LTG2012/super-dial-motor-knob-screen/superdial使用说明书.pdf

默认 HID

设置界面

亮度：范围 1-100，转动到低时有电机软限位
息屏时间：不操作时屏幕熄灭；可选 30 秒、1 分钟、3 分钟、5 分钟、10 分钟、15 分钟、 从不息屏
关机时间：不操作自动关机时间；可选 1 分钟、3 分钟、5 分钟、10 分钟、15 分钟、30 分 钟、从不息屏
屏幕方向:屏幕显示方向；四个方向可调，每个方向间隔 90 度
Wifi：
STA 联网模式；长按联网后会访问对应的 wifi 热点，成功时会显示 IP 地址。在同一 wifi 热点内，打开浏览器访问 IP 地址会有设置网页
AP 热点模式；第一次使用需要进入到 AP 热点模式进行配网，wifi 名称“Superdial-xxxxxx”， 后六位是设备唯一 ID，在验证码获取时候需要填入后六位设备唯一 ID；验证码获取可以参 考项目 readme 里面说明，项目说明：https://gitee.com/coll45/super-dial-motor-knobscreen。选中对应 (https://gitee.com/coll45/super-dial-motor-knob-screen) wifi 名称，填入密码和验证码 默认首页：开机启动后默认打开的页面；可选首页，默认 HID，自定义 HID
