LTG2012/super-dial-motor-knob-screen/image/wifi_pwd.png

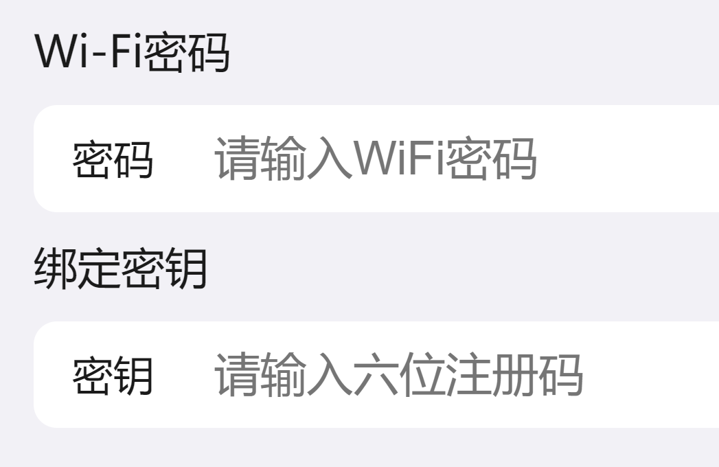
image/wifi_pwd.png
