LTG2012/super-dial-motor-knob-screen/image/wifi_ssid.png

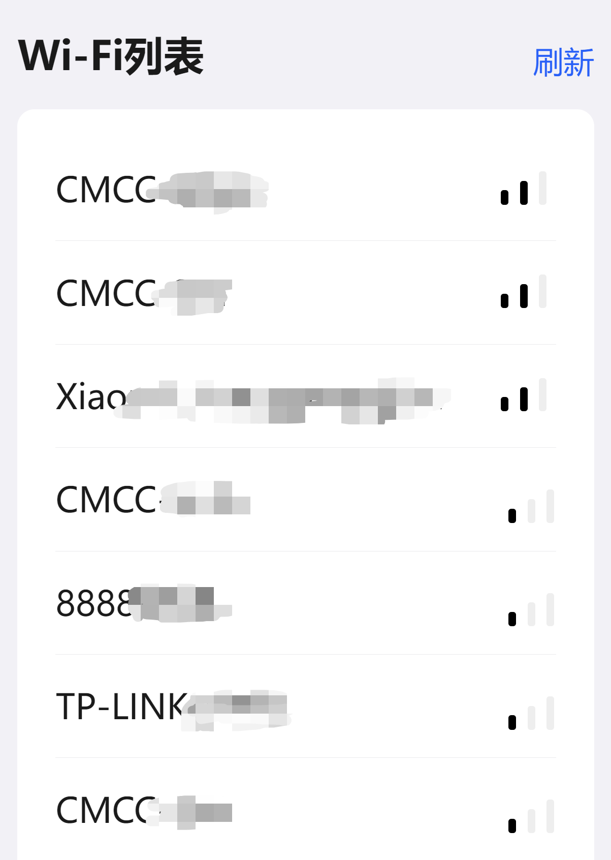
image/wifi_ssid.png
