LTG2012/super-dial-motor-knob-screen/image/首页2.png

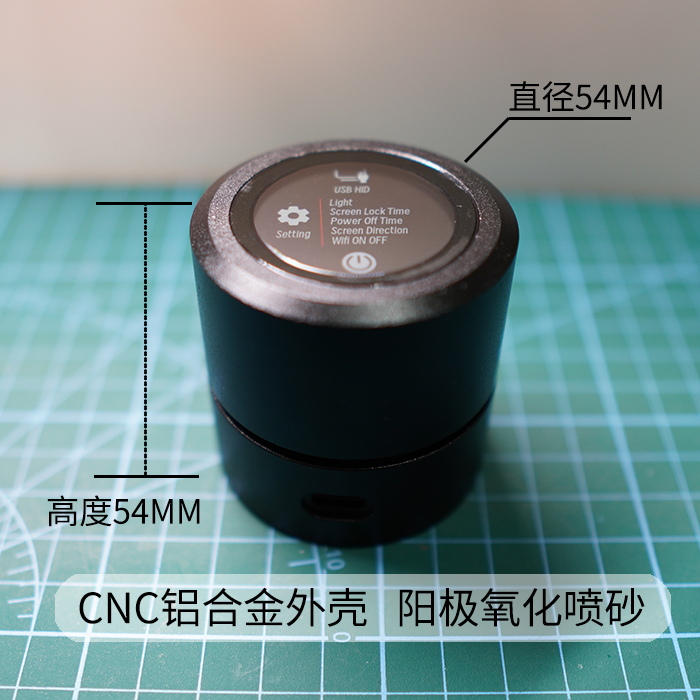
image/首页2.png
