LTG2012/super-dial-motor-knob-screen/3205B电机SuperDial_Bom.xlsx

Sheet: 打印或CNC
SuperDial电机旋钮屏V2物料清单（打印件）
除旋钮外，均不需要添加支撑
旋钮同时支持CNC加工和3D打印
详见stl文件和step文件

Sheet: 其他辅料
SuperDial电机旋钮屏V2物料清单（其他辅料） |  |  |  | 链接
序号 | 数量 | 名称 | 备注
1 | 1 | 直径40mm厚度1mm玻璃 | 屏幕保护 | https://item.taobao.com/item.htm?abbucket=20&id=553695645065&ns=1&skuId=3728391490097
2 | 4 | M2*3杯头内六角螺丝 | 固定转子套 | https://detail.tmall.com/item.htm?id=43519715236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
3 | 3 | M2*5螺丝 | 固定主控和底座 | 可在上面链接配齐
4 | 1 | M2.5*5螺丝 | 辅助铜柱焊接 | 螺丝数量为用到的数量，实际上做一套旋钮只需要每个规格螺丝拍一件商品就行
5 | 6 | M2*12内六角半牙螺丝 | 穿过驱动板固定到电机/穿过主控板固定到适配器 | https://detail.tmall.com/item.htm?_u=p1sddf3sf272&id=687938827035&skuId=5075553231849
6 | 4 | M2*6.6MM飞控避震柱 | 套在半牙M2*12螺丝外 | https://item.taobao.com/item.htm?_u=p1sddf3s656f&id=648151872187&skuId=4864013272254
7 | 1 | M2.5*25六角铜柱双通 | 过屏幕线，得用（佰瑞特紧固件企业店）的铜柱 | https://item.taobao.com/item.htm?_u=p1sddf3s5d27&id=20345879255&skuId=5173597151816
8 | 1 | 502胶水 | 固定屏幕玻璃到打印件上
9 | 1 | 间距0.8mm 8P 32AWG单头线 | 屏幕线，长度20cm | https://item.taobao.com/item.htm?_u=p1sddf3sefb6&id=582653807364&skuId=4510259621478
10 | 1 | 间距0.8mm 8P 32AWG双头同向线 | 连接驱动和主控，越短越好（可定制） | 上面链接8p双头同向10cm长度的也可以用，就是要稍微理一下线
11 | 1 | 3205电机B款 无限位 | 在45菌店铺买无限位款可以备注（旋钮）会送对应适配器 | https://item.taobao.com/item.htm?id=734772197083&skuId=5254200511031
12 | 1 | 2P杜邦线适量长度 | 连接主控和驱动，导线自己裁剪合适长度
13 | 1 | 602535锂电池 600mAh | 可小不可大；不带插头、xh2.54和ph2.0均可（线长50mm） | https://item.taobao.com/item.htm?_u=p1sddf3s11e1&id=619805501404&skuId=4627654124871
14 | 1 | 0.15mm双面胶适量 | 固定屏幕，旋钮套和外壳固定
15 | 1 | FPC软天线IPEX 1代 | A款FPC 5DB 37*10mm 线总长6cm IPEX 1代 | https://item.taobao.com/item.htm?_u=p1sddf3s7e17&id=586127342811&skuId=4017577965337
16 | 1 | 直径54mm左右防滑硅胶垫 | 贴在底座底面（定制） | 不影响功能，可不买
17 | 1 | 1.28寸TFT液晶显示屏GC9A01驱动 | 标准焊接款（不带触摸） | https://item.taobao.com/item.htm?_u=q1sddf3sfeb4&id=674420369037&skuId=5027778451275
18 | 1 | ESP32S3-N16R8 | 立创原理图上用的是N8是错的，需要买N16R8 | https://item.taobao.com/item.htm?abbucket=16&id=676604026231&ns=1&skuId=5035236575059
