LTG2012/super-dial-motor-knob-screen/idf_code/components/espressif__esp_lvgl_port/docs/frame_buffer_settings.png

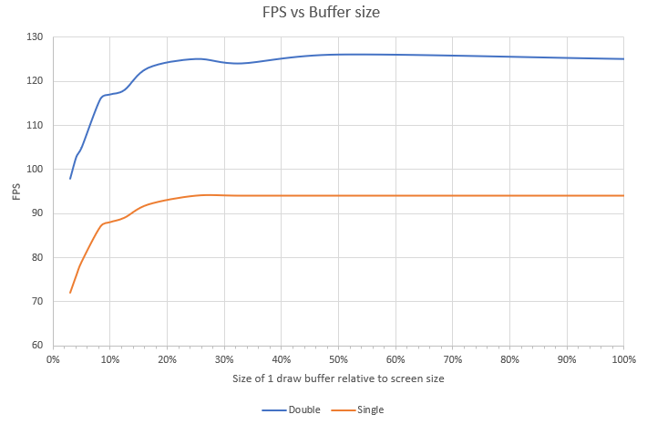
idf_code/components/espressif__esp_lvgl_port/docs/frame_buffer_settings.png
