LTG2012/super-dial-motor-knob-screen/3D打印和CNC模型-by虫二/3205b适配器.STEP

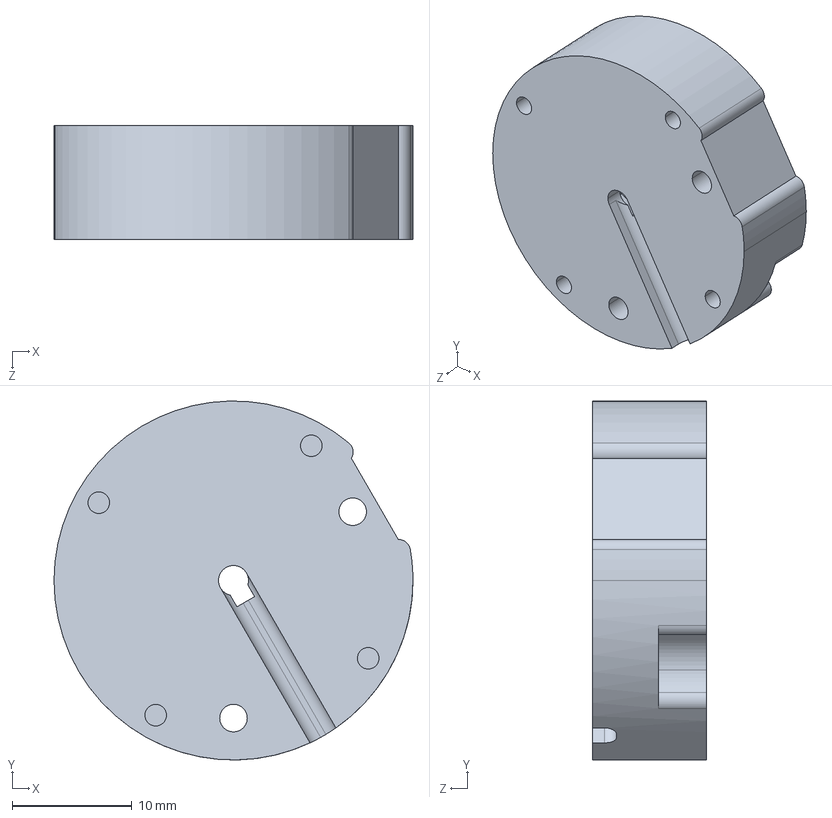
[picture p43: CAD file, 2024-04-28]
3D打印和CNC模型-by虫二/3205b适配器.STEP
30.0 x 30.0 x 9.50 mm
