LTG2012/super-dial-motor-knob-screen/3D打印和CNC模型-by虫二/旋钮上盖.STEP

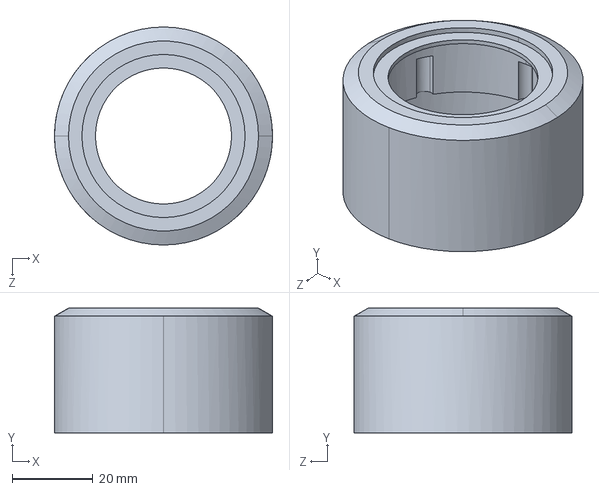
[picture p44: CAD file, 2024-01-25]
3D打印和CNC模型-by虫二/旋钮上盖.STEP
54.0 x 30.9 x 54.0 mm
