LTG2012/super-dial-motor-knob-screen/3D打印和CNC模型-by虫二/3205b电机转子套.STEP

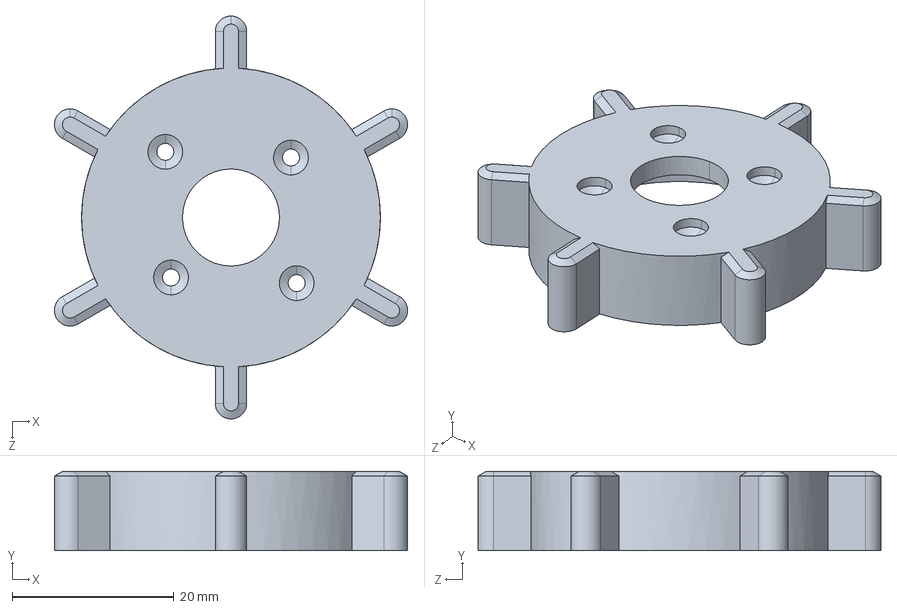
[picture p45: CAD file, 2024-01-25]
3D打印和CNC模型-by虫二/3205b电机转子套.STEP
43.7 x 9.80 x 49.9 mm
