LTG2012/super-dial-motor-knob-screen/3D打印和CNC模型-by虫二/旋钮底座.STEP

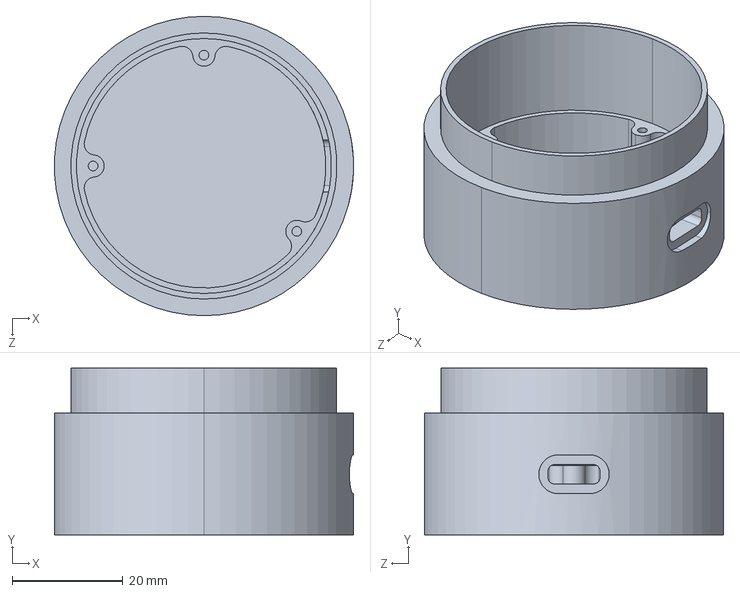
[picture p46: CAD file, 2024-01-25]
3D打印和CNC模型-by虫二/旋钮底座.STEP
53.9 x 30.1 x 54.0 mm
