LTG2012/super-dial-motor-knob-screen/3D打印和CNC模型-by虫二/旧版本3205A电机结构模型_仅供参考/01.旋钮.STL

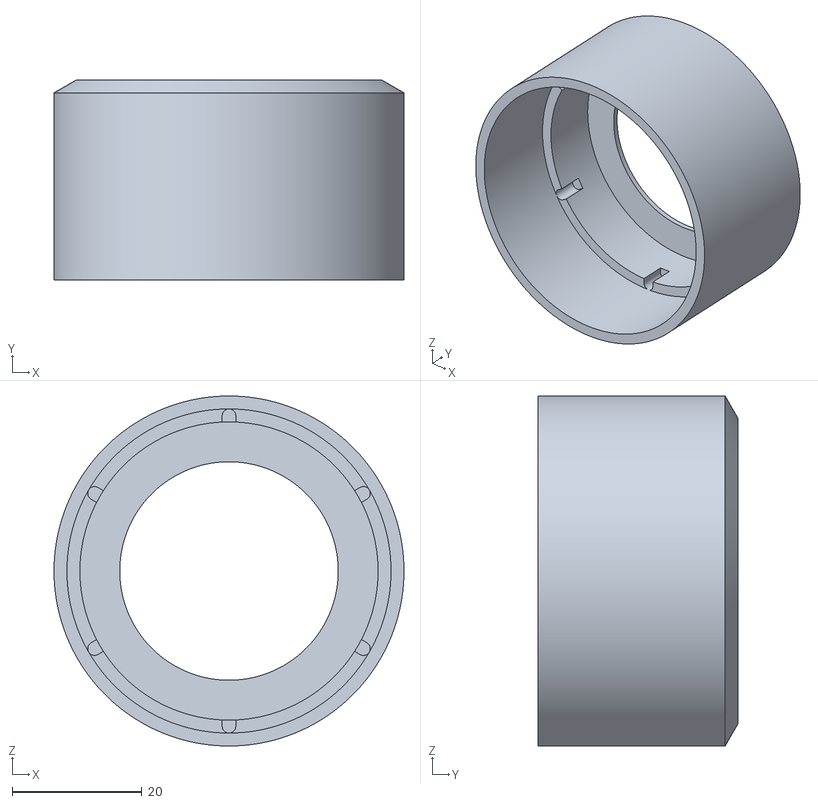
[picture p47: CAD file, 2024-01-25, an earlier design]
3D打印和CNC模型-by虫二/旧版本3205A电机结构模型_仅供参考/01.旋钮.STL
54.0 x 30.9 x 54.0
