LTG2012/super-dial-motor-knob-screen/3D打印和CNC模型-by虫二/旧版本3205A电机结构模型_仅供参考/04.转子套.STL

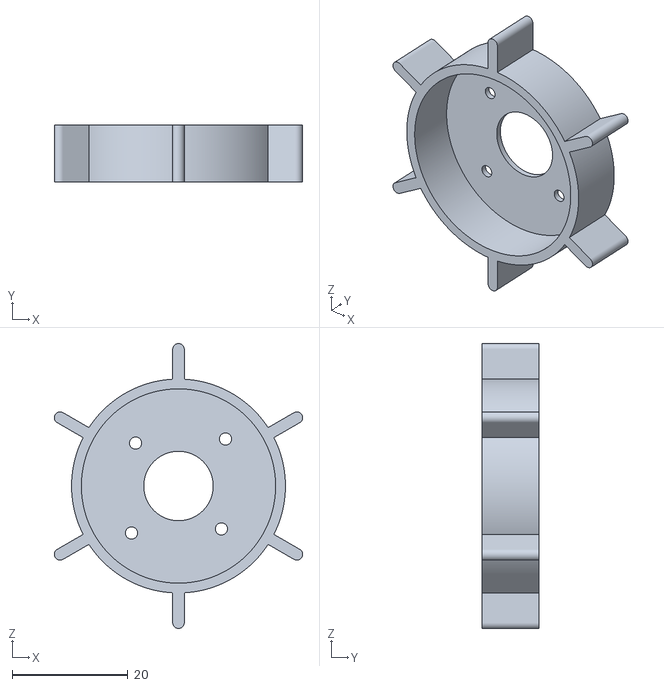
[picture p48: CAD file, 2024-01-25, an earlier design]
3D打印和CNC模型-by虫二/旧版本3205A电机结构模型_仅供参考/04.转子套.STL
43.0 x 9.80 x 49.3
