LTG2012/super-dial-motor-knob-screen/3D打印和CNC模型-by虫二/旧版本3205A电机结构模型_仅供参考/03.适配器.STL

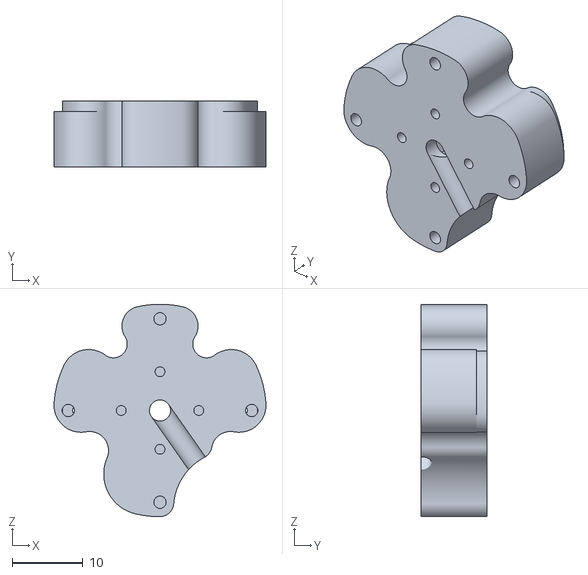
[picture p49: CAD file, 2024-01-25, an earlier design]
3D打印和CNC模型-by虫二/旧版本3205A电机结构模型_仅供参考/03.适配器.STL
30.0 x 9.40 x 30.1
