LTG2012/super-dial-motor-knob-screen/(list of files, cad)

Other CAD files:
3D打印和CNC模型-by虫二/旧版本3205A电机结构模型_仅供参考/02.底座.STL
3D打印和CNC模型-by虫二/旧版本3205A电机结构模型_仅供参考/01.旋钮CNC用.STEP
