LTG2012/super-dial-motor-knob-screen/idf_code/components/espressif__tinyusb/hw/bsp/stm32h7/boards/stm32h743eval/board.h

/*
 * The MIT License (MIT)
 *
 * Copyright (c) 2021, Ha Thach (tinyusb.org)
 *
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
 * This file is part of the TinyUSB stack.
 */

#ifndef BOARD_H_
#define BOARD_H_

#ifdef __cplusplus
 extern "C" {
#endif

#define LED_PORT              GPIOA
#define LED_PIN               GPIO_PIN_4
#define LED_STATE_ON          1

// Tamper push-button
#define BUTTON_PORT           GPIOC
#define BUTTON_PIN            GPIO_PIN_13
#define BUTTON_STATE_ACTIVE   0

// Need to change jumper setting J7 and J8 from RS-232 to STLink
#define UART_DEV              USART1
#define UART_CLK_EN           __HAL_RCC_USART1_CLK_ENABLE
#define UART_GPIO_PORT        GPIOB
#define UART_GPIO_AF          GPIO_AF4_USART1
#define UART_TX_PIN           GPIO_PIN_14
#define UART_RX_PIN           GPIO_PIN_15

// VBUS Sense detection
#define OTG_FS_VBUS_SENSE     1
#define OTG_HS_VBUS_SENSE     0

// USB HS External PHY Pin: CLK, STP, DIR, NXT, D0-D7
#define ULPI_PINS \
  {GPIOA, GPIO_PIN_3 }, {GPIOA, GPIO_PIN_5 }, {GPIOB, GPIO_PIN_0 }, {GPIOB, GPIO_PIN_1 }, \
  {GPIOB, GPIO_PIN_5 }, {GPIOB, GPIO_PIN_10}, {GPIOB, GPIO_PIN_11}, {GPIOB, GPIO_PIN_12}, \
  {GPIOB, GPIO_PIN_13}, {GPIOC, GPIO_PIN_0 }, {GPIOH, GPIO_PIN_4 }, {GPIOI, GPIO_PIN_11}

//--------------------------------------------------------------------+
// RCC Clock
//--------------------------------------------------------------------+
static inline void board_stm32h7_clock_init(void)
{
  RCC_ClkInitTypeDef RCC_ClkInitStruct = { 0 };
  RCC_OscInitTypeDef RCC_OscInitStruct = { 0 };
  RCC_PeriphCLKInitTypeDef PeriphClkInitStruct = { 0 };

  /*!< Supply configuration update enable */
  HAL_PWREx_ConfigSupply(PWR_LDO_SUPPLY);

  /* The voltage scaling allows optimizing the power consumption when the device is
     clocked below the maximum system frequency, to update the voltage scaling value
     regarding system frequency refer to product datasheet.  */
  __HAL_PWR_VOLTAGESCALING_CONFIG(PWR_REGULATOR_VOLTAGE_SCALE1);

  while ((PWR->D3CR & (PWR_D3CR_VOSRDY)) != PWR_D3CR_VOSRDY) {}

  /* Enable HSE Oscillator and activate PLL with HSE as source */
  RCC_OscInitStruct.OscillatorType = RCC_OSCILLATORTYPE_HSE;
  RCC_OscInitStruct.HSEState = RCC_HSE_ON;
  RCC_OscInitStruct.HSIState = RCC_HSI_OFF;
  RCC_OscInitStruct.CSIState = RCC_CSI_OFF;
  RCC_OscInitStruct.PLL.PLLState = RCC_PLL_ON;
  RCC_OscInitStruct.PLL.PLLSource = RCC_PLLSOURCE_HSE;

  // PLL1 for System Clock
#ifdef TRACE_ETM
  // From H743 eval board manual
  // - ETM can only work at 50 MHz clock by default because ETM signals are shared with other peripherals. If better
  //   performance of ETM is required (84 MHz/98 MHz), R217, R230, R231, R234, R236, SB2, SB5, SB8, SB11,
  //   SB42, SB57 must be removed to reduce the stub on ETM signals. In this configuration SAI and PDM are not
  //   functional and NOR Flash and the address of SRAM are limited on A18.
  // - ETM trace function would be abnormal as SAI_SDB share the same pins with TRACE_D0, and TRACE_D0
  //   would be forced high by SAI_SDB. When using ETM trace it is necessary to set ADCDAT1 pin (SAI_SDB signal
  //   of the STM32) of audio codec WM8994ECS/R (U22) by software to be tri-state.

  // Since Trace CLK = PLL1 / 3 --> max PLL1 clock is 150Mhz
  RCC_OscInitStruct.PLL.PLLM = 2;
  RCC_OscInitStruct.PLL.PLLN = 24;
  RCC_OscInitStruct.PLL.PLLP = 2;
  RCC_OscInitStruct.PLL.PLLQ = 4;
  RCC_OscInitStruct.PLL.PLLR = 2;
  RCC_OscInitStruct.PLL.PLLFRACN = 0;
#else
  // Set PLL1 to 400Mhz
  RCC_OscInitStruct.PLL.PLLM = 5;
  RCC_OscInitStruct.PLL.PLLN = 160;
  RCC_OscInitStruct.PLL.PLLP = 2;
  RCC_OscInitStruct.PLL.PLLR = 2;
  RCC_OscInitStruct.PLL.PLLQ = 4;
#endif
  RCC_OscInitStruct.PLL.PLLVCOSEL = RCC_PLL1VCOMEDIUM;
  RCC_OscInitStruct.PLL.PLLRGE = RCC_PLL1VCIRANGE_2;
  HAL_RCC_OscConfig(&RCC_OscInitStruct);


  /* Select PLL as system clock source and configure bus clocks dividers */
  RCC_ClkInitStruct.ClockType = RCC_CLOCKTYPE_HCLK | RCC_CLOCKTYPE_SYSCLK | RCC_CLOCKTYPE_PCLK1 |
      RCC_CLOCKTYPE_PCLK2 | RCC_CLOCKTYPE_D1PCLK1 | RCC_CLOCKTYPE_D3PCLK1;

  RCC_ClkInitStruct.SYSCLKSource = RCC_SYSCLKSOURCE_PLLCLK;
  RCC_ClkInitStruct.SYSCLKDivider = RCC_SYSCLK_DIV1;
  RCC_ClkInitStruct.AHBCLKDivider = RCC_HCLK_DIV2;
  RCC_ClkInitStruct.APB1CLKDivider = RCC_APB1_DIV2;
  RCC_ClkInitStruct.APB2CLKDivider = RCC_APB2_DIV2;
  RCC_ClkInitStruct.APB3CLKDivider = RCC_APB3_DIV2;
  HAL_RCC_ClockConfig(&RCC_ClkInitStruct, FLASH_LATENCY_2);

  /* PLL3 for USB Clock */
  PeriphClkInitStruct.PLL3.PLL3M = 25;
  PeriphClkInitStruct.PLL3.PLL3N = 336;
  PeriphClkInitStruct.PLL3.PLL3FRACN = 0;
  PeriphClkInitStruct.PLL3.PLL3P = 2;
  PeriphClkInitStruct.PLL3.PLL3Q = 7;
  PeriphClkInitStruct.PLL3.PLL3R = 2;

  PeriphClkInitStruct.PeriphClockSelection = RCC_PERIPHCLK_USB;
  PeriphClkInitStruct.UsbClockSelection = RCC_USBCLKSOURCE_PLL3;
  HAL_RCCEx_PeriphCLKConfig(&PeriphClkInitStruct);

  /*activate CSI clock mondatory for I/O Compensation Cell*/
  __HAL_RCC_CSI_ENABLE() ;

  /* Enable SYSCFG clock mondatory for I/O Compensation Cell */
  __HAL_RCC_SYSCFG_CLK_ENABLE() ;

  /* Enables the I/O Compensation Cell */
  HAL_EnableCompensationCell();
}

static inline void board_stm32h7_post_init(void)
{
  // For this board does nothing
}

#ifdef __cplusplus
 }
#endif

#endif
