LTG2012/super-dial-motor-knob-screen/idf_code/components/espressif__arduino-foc/src/common/base_classes/StepperDriver.h

#ifndef STEPPERDRIVER_H
#define STEPPERDRIVER_H

#include "drivers/hardware_api.h"

class StepperDriver{
    public:
        
        /** Initialise hardware */
        virtual int init() = 0;
        /** Enable hardware */
        virtual void enable() = 0;
        /** Disable hardware */
        virtual void disable() = 0;

        long pwm_frequency; //!< pwm frequency value in hertz
        float voltage_power_supply; //!< power supply voltage 
        float voltage_limit; //!< limiting voltage set to the motor
        
        bool initialized = false; // true if driver was successfully initialized
        void* params = 0; // pointer to hardware specific parameters of driver

        /** 
         * Set phase voltages to the harware 
         * 
         * @param Ua phase A voltage
         * @param Ub phase B voltage
        */
        virtual void setPwm(float Ua, float Ub) = 0;
};

#endif
