LTG2012/super-dial-motor-knob-screen/idf_code/components/espressif__esp_tinyusb/include/tusb_config.h

/*
 * SPDX-FileCopyrightText: 2019 Ha Thach (tinyusb.org),
 * SPDX-FileContributor: 2020 Espressif Systems (Shanghai) CO LTD
 * SPDX-License-Identifier: MIT
 *
 * Copyright (c) 2019 Ha Thach (tinyusb.org),
 * Additions Copyright (c) 2020, Espressif Systems (Shanghai) PTE LTD
 *
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
 */

#pragma once

#include "tusb_option.h"
#include "sdkconfig.h"

#ifdef __cplusplus
extern "C" {
#endif

#ifndef CONFIG_TINYUSB_CDC_ENABLED
#   define CONFIG_TINYUSB_CDC_ENABLED 0
#endif

#ifndef CONFIG_TINYUSB_CDC_COUNT
#   define CONFIG_TINYUSB_CDC_COUNT 0
#endif

#ifndef CONFIG_TINYUSB_MSC_ENABLED
#   define CONFIG_TINYUSB_MSC_ENABLED 0
#endif

#ifndef CONFIG_TINYUSB_HID_COUNT
#   define CONFIG_TINYUSB_HID_COUNT 0
#endif

#ifndef CONFIG_TINYUSB_MIDI_COUNT
#   define CONFIG_TINYUSB_MIDI_COUNT 0
#endif

#ifndef CONFIG_TINYUSB_CUSTOM_CLASS_ENABLED
#   define CONFIG_TINYUSB_CUSTOM_CLASS_ENABLED 0
#endif

#ifndef CONFIG_TINYUSB_NET_MODE_ECM_RNDIS
#   define CONFIG_TINYUSB_NET_MODE_ECM_RNDIS 0
#endif

#ifndef CONFIG_TINYUSB_NET_MODE_NCM
#   define CONFIG_TINYUSB_NET_MODE_NCM 0
#endif

#ifndef CONFIG_TINYUSB_DFU_MODE_DFU
#   define CONFIG_TINYUSB_DFU_MODE_DFU 0
#endif

#ifndef CONFIG_TINYUSB_DFU_MODE_DFU_RUNTIME
#   define CONFIG_TINYUSB_DFU_MODE_DFU_RUNTIME 0
#endif

#ifndef CONFIG_TINYUSB_BTH_ENABLED
#   define CONFIG_TINYUSB_BTH_ENABLED 0
#   define CONFIG_TINYUSB_BTH_ISO_ALT_COUNT 0
#endif

#ifndef CONFIG_TINYUSB_DEBUG_LEVEL
#   define CONFIG_TINYUSB_DEBUG_LEVEL 0
#endif

#ifdef CONFIG_TINYUSB_RHPORT_HS
#   define CFG_TUSB_RHPORT1_MODE    OPT_MODE_DEVICE | OPT_MODE_HIGH_SPEED
#else
#   define CFG_TUSB_RHPORT0_MODE    OPT_MODE_DEVICE | OPT_MODE_FULL_SPEED
#endif

#define CFG_TUSB_OS                 OPT_OS_FREERTOS

/* USB DMA on some MCUs can only access a specific SRAM region with restriction on alignment.
 * Tinyusb use follows macros to declare transferring memory so that they can be put
 * into those specific section.
 * e.g
 * - CFG_TUSB_MEM SECTION : __attribute__ (( section(".usb_ram") ))
 * - CFG_TUSB_MEM_ALIGN   : __attribute__ ((aligned(4)))
 */
#ifndef CFG_TUSB_MEM_SECTION
#   define CFG_TUSB_MEM_SECTION
#endif

#ifndef CFG_TUSB_MEM_ALIGN
#   define CFG_TUSB_MEM_ALIGN       TU_ATTR_ALIGNED(4)
#endif

#ifndef CFG_TUD_ENDPOINT0_SIZE
#define CFG_TUD_ENDPOINT0_SIZE      64
#endif

// Debug Level
#define CFG_TUSB_DEBUG              CONFIG_TINYUSB_DEBUG_LEVEL

// CDC FIFO size of TX and RX
#define CFG_TUD_CDC_RX_BUFSIZE      CONFIG_TINYUSB_CDC_RX_BUFSIZE
#define CFG_TUD_CDC_TX_BUFSIZE      CONFIG_TINYUSB_CDC_TX_BUFSIZE

// MSC Buffer size of Device Mass storage
#define CFG_TUD_MSC_BUFSIZE         CONFIG_TINYUSB_MSC_BUFSIZE

// MIDI macros
#define CFG_TUD_MIDI_EP_BUFSIZE     64
#define CFG_TUD_MIDI_EPSIZE         CFG_TUD_MIDI_EP_BUFSIZE
#define CFG_TUD_MIDI_RX_BUFSIZE     64
#define CFG_TUD_MIDI_TX_BUFSIZE     64

// Vendor FIFO size of TX and RX
// If not configured vendor endpoints will not be buffered
#define CFG_TUD_VENDOR_RX_BUFSIZE   64
#define CFG_TUD_VENDOR_TX_BUFSIZE   64

// DFU macros
#define CFG_TUD_DFU_XFER_BUFSIZE    CONFIG_TINYUSB_DFU_BUFSIZE

// Number of BTH ISO alternatives
#define CFG_TUD_BTH_ISO_ALT_COUNT   CONFIG_TINYUSB_BTH_ISO_ALT_COUNT

// Enabled device class driver
#define CFG_TUD_CDC                 CONFIG_TINYUSB_CDC_COUNT
#define CFG_TUD_MSC                 CONFIG_TINYUSB_MSC_ENABLED
#define CFG_TUD_HID                 CONFIG_TINYUSB_HID_COUNT
#define CFG_TUD_MIDI                CONFIG_TINYUSB_MIDI_COUNT
#define CFG_TUD_CUSTOM_CLASS        CONFIG_TINYUSB_CUSTOM_CLASS_ENABLED
#define CFG_TUD_ECM_RNDIS           CONFIG_TINYUSB_NET_MODE_ECM_RNDIS
#define CFG_TUD_NCM                 CONFIG_TINYUSB_NET_MODE_NCM
#define CFG_TUD_DFU                 CONFIG_TINYUSB_DFU_MODE_DFU
#define CFG_TUD_DFU_RUNTIME         CONFIG_TINYUSB_DFU_MODE_DFU_RUNTIME
#define CFG_TUD_BTH                 CONFIG_TINYUSB_BTH_ENABLED

#ifdef __cplusplus
}
#endif
