LTG2012/super-dial-motor-knob-screen/idf_code/main/display/display.c

#include <stdio.h>
#include "esp_heap_caps.h"
#include "display.h"

static const char *TAG = "DISPLAY";

/* LCD IO and panel */
static esp_lcd_panel_io_handle_t lcd_io = NULL;
static esp_lcd_panel_handle_t lcd_panel = NULL;

/* LVGL display and touch */
static lv_disp_t *lvgl_disp = NULL;
static lv_timer_t *bat_task = NULL;
static esp_err_t app_lcd_init(void)
{
    esp_err_t ret = ESP_OK;

    /* LCD initialization */
    ESP_LOGD(TAG, "Initialize SPI bus");
    const spi_bus_config_t buscfg = {
        .sclk_io_num = EXAMPLE_LCD_GPIO_SCLK,
        .mosi_io_num = EXAMPLE_LCD_GPIO_MOSI,
        .miso_io_num = GPIO_NUM_NC,
        .quadwp_io_num = GPIO_NUM_NC,
        .quadhd_io_num = GPIO_NUM_NC,
        .max_transfer_sz = EXAMPLE_LCD_H_RES * EXAMPLE_LCD_DRAW_BUFF_HEIGHT * sizeof(uint16_t),
    };
    ESP_RETURN_ON_ERROR(spi_bus_initialize(EXAMPLE_LCD_SPI_NUM, &buscfg, SPI_DMA_CH_AUTO), TAG, "SPI init failed");

    ESP_LOGD(TAG, "Install panel IO");
    const esp_lcd_panel_io_spi_config_t io_config = {
        .dc_gpio_num = EXAMPLE_LCD_GPIO_DC,
        .cs_gpio_num = EXAMPLE_LCD_GPIO_CS,
        .pclk_hz = EXAMPLE_LCD_PIXEL_CLK_HZ,
        .lcd_cmd_bits = EXAMPLE_LCD_CMD_BITS,
        .lcd_param_bits = EXAMPLE_LCD_PARAM_BITS,
        .spi_mode = 0,
        .trans_queue_depth = 10,
    };
    ESP_GOTO_ON_ERROR(esp_lcd_new_panel_io_spi((esp_lcd_spi_bus_handle_t)EXAMPLE_LCD_SPI_NUM, &io_config, &lcd_io), err, TAG, "New panel IO failed");

    ESP_LOGD(TAG, "Install LCD driver");
    const esp_lcd_panel_dev_config_t panel_config = {
        .reset_gpio_num = EXAMPLE_LCD_GPIO_RST,
        .color_space = EXAMPLE_LCD_COLOR_SPACE,
        .bits_per_pixel = EXAMPLE_LCD_BITS_PER_PIXEL,
    };
    ESP_GOTO_ON_ERROR(esp_lcd_new_panel_gc9a01(lcd_io, &panel_config, &lcd_panel), err, TAG, "New panel failed");

    esp_lcd_panel_reset(lcd_panel);
    esp_lcd_panel_init(lcd_panel);
    esp_lcd_panel_mirror(lcd_panel, true, true);
    esp_lcd_panel_invert_color(lcd_panel,true);
    esp_lcd_panel_disp_on_off(lcd_panel, true);

    /* LCD backlight on */
    // Prepare and then apply the LEDC PWM timer configuration
    ledc_timer_config_t ledc_timer = {
        .speed_mode       = LEDC_MODE,
        .timer_num        = LEDC_TIMER,
        .duty_resolution  = LEDC_DUTY_RES,
        .freq_hz          = LEDC_FREQUENCY,  // Set output frequency at 4 kHz
        .clk_cfg          = LEDC_AUTO_CLK
    };
    ESP_ERROR_CHECK(ledc_timer_config(&ledc_timer));

    // Prepare and then apply the LEDC PWM channel configuration
    ledc_channel_config_t ledc_channel = {
        .speed_mode     = LEDC_MODE,
        .channel        = LEDC_CHANNEL,
        .timer_sel      = LEDC_TIMER,
        .intr_type      = LEDC_INTR_DISABLE,
        .gpio_num       = LEDC_OUTPUT_IO,
        .duty           = 0, // Set duty to 0%
        .hpoint         = 0
    };
    ESP_ERROR_CHECK(ledc_channel_config(&ledc_channel));
    ESP_ERROR_CHECK(ledc_set_duty(LEDC_MODE, LEDC_CHANNEL, 0));
    // Update duty to apply the new value
    ESP_ERROR_CHECK(ledc_update_duty(LEDC_MODE, LEDC_CHANNEL));
    return ret;

err:
    if (lcd_panel) {
        esp_lcd_panel_del(lcd_panel);
    }
    if (lcd_io) {
        esp_lcd_panel_io_del(lcd_io);
    }
    spi_bus_free(EXAMPLE_LCD_SPI_NUM);
    return ret;
}

static esp_err_t app_lvgl_init(void)
{
    /* Initialize LVGL */
    const lvgl_port_cfg_t lvgl_cfg = {
        .task_priority = 4,         /* LVGL task priority */
        .task_stack = 4096,         /* LVGL task stack size */
        .task_affinity = -1,        /* LVGL task pinned to core (-1 is no affinity) */
        .task_max_sleep_ms = 500,   /* Maximum sleep in LVGL task */
        .timer_period_ms = 5        /* LVGL timer tick period in ms */
    };
    ESP_RETURN_ON_ERROR(lvgl_port_init(&lvgl_cfg), TAG, "LVGL port initialization failed");

    /* Add LCD screen */
    ESP_LOGD(TAG, "Add LCD screen");
    const lvgl_port_display_cfg_t disp_cfg = {
        .io_handle = lcd_io,
        .panel_handle = lcd_panel,
        .buffer_size = EXAMPLE_LCD_H_RES * EXAMPLE_LCD_DRAW_BUFF_HEIGHT * sizeof(uint16_t),
        .double_buffer = EXAMPLE_LCD_DRAW_BUFF_DOUBLE,
        .hres = EXAMPLE_LCD_H_RES,
        .vres = EXAMPLE_LCD_V_RES,
        .monochrome = false,
        /* Rotation values must be same as used in esp_lcd for initial settings of the screen */
        .rotation = {
            .swap_xy = false,
            .mirror_x = true,
            .mirror_y = false,
        },
        .flags = {
            .buff_dma = true,
        }
    };
    lvgl_disp = lvgl_port_add_disp(&disp_cfg);
    uint8_t val = nvs_get_u8_data(SET_NVS_ROTATION);
    if(val<4)
        lv_disp_set_rotation(lvgl_disp, val);
    else
        lv_disp_set_rotation(lvgl_disp, LV_DISP_ROT_NONE);

    return ESP_OK;
}
void set_screen_rotation(uint8_t val)
{
    static uint8_t last_val=255;
    if(last_val == val)
        return;
    else
    {
        if(val<4)
            lv_disp_set_rotation(lvgl_disp, val);
        else
            lv_disp_set_rotation(lvgl_disp, LV_DISP_ROT_NONE);
    }
    last_val = val;
}
void set_screen_light(uint8_t duty)
{
    uint32_t num = duty;
    ESP_ERROR_CHECK(ledc_set_duty(LEDC_MODE, LEDC_CHANNEL, 1024*0.01*duty));
    ESP_ERROR_CHECK(ledc_update_duty(LEDC_MODE, LEDC_CHANNEL));
}
void display_init(void)
{
     /* LCD HW initialization */
    ESP_ERROR_CHECK(app_lcd_init());

    /* LVGL initialization */
    ESP_ERROR_CHECK(app_lvgl_init());
    uint8_t val = sys_config.set_light;
    if(val>0&&val<=100)
        set_screen_light(val);
    else
        set_screen_light(50);

}

static void load_custom_bg(void)
{
    char filename[32];
    snprintf(filename, sizeof(filename), "/spiffs/bg_%d.bin", sys_config.bg_index);
    
    FILE *f = fopen(filename, "rb");
    if (!f) {
        // Fallback to old name if index is 0 and new name not found
        if (sys_config.bg_index == 0) {
            f = fopen("/spiffs/bg_custom.bin", "rb");
        }
    }
    
    if (!f) {
        ESP_LOGI(TAG, "No custom background found for index %d", sys_config.bg_index);
        return;
    }
    
    fseek(f, 0, SEEK_END);
    size_t size = ftell(f);
    fseek(f, 0, SEEK_SET);
    
    // Check size: 240 * 240 * 2 (RGB565) = 115200 bytes
    // If size is different, it might be corrupted or different format
    if (size != 240 * 240 * 2) {
        ESP_LOGW(TAG, "Invalid custom background size: %d", size);
        fclose(f);
        return;
    }
    
    uint8_t *data = heap_caps_malloc(size, MALLOC_CAP_SPIRAM);
    if (!data) {
        ESP_LOGE(TAG, "Failed to allocate memory for background");
        fclose(f);
        return;
    }
    
    fread(data, 1, size, f);
    fclose(f);
    
    static lv_img_dsc_t bg_dsc;
    bg_dsc.header.always_zero = 0;
    bg_dsc.header.w = 240;
    bg_dsc.header.h = 240;
    bg_dsc.data_size = size;
    bg_dsc.header.cf = LV_IMG_CF_TRUE_COLOR;
    bg_dsc.data = data;
    
    if (ui_Screen1) { 
         lv_obj_set_style_bg_img_src(ui_Screen1, &bg_dsc, LV_PART_MAIN | LV_STATE_DEFAULT);
         ESP_LOGI(TAG, "Custom background loaded");
    }
}
void lvgl_display_init(void)
{
    /* Task lock */
    lvgl_port_lock(0);

    ui_init();
    load_custom_bg();
    /* Task unlock */
    lvgl_port_unlock();
}
