LTG2012/super-dial-motor-knob-screen/(commit log)

2023-02-10 主控更新并不再修改，开源最新固件以及代码
    [SuperDial电机旋钮屏V2_Bom.xlsx]
2023-02-14 修改上电代码启动顺序，确保休眠能够正常唤醒
2023-02-14 修复上电顺序
2023-02-19 看门狗、休眠、修复两个界面切换后位置错误
2023-03-03 bin文件新增屏幕0度 和 180度可以更换屏幕正反面
2023-04-30 添加换图功能 仪表盘界面添加亮度界面
2023-07-31 删除旧bin
2023-09-18 修复了flashdownload波特率设置太高容易出错问题
2024-01-25 更新3205b型号电机bom
    [01.旋钮.STL, 01.旋钮CNC用.STEP, 02.底座.STL, 03.适配器.STL, 04.转子套.STL, 3205A电机BOM_电机已无货_仅供参考.xlsx, 3205b电机转子套.STEP, SuperDial电机旋钮屏V2_Bom.xlsx]
2024-04-28 新的bin文件，用idf写的可以自行选择bin文件烧录
    [3205b适配器.STEP, 新3205B电机SuperDial_Bom.xlsx]
2024-04-30 装配教程
2024-05-30 idf固件更新
    [3205A电机BOM_电机已无货_仅供参考.xlsx, 3205B电机SuperDial_Bom.xlsx]
2024-06-09 idf固件小bug修复
2024-06-16 idf固件双击bug修复，网页内置css，js文件
2024-08-05 新增自定义mqtt消息功能，可以与ha联动智能家居
2026-01-26 Revert "feat: add LVGL PC simulator"
    This reverts commit 74e5c0f98bc08b833823be475591e9e7ecaae799.
    [dial_power.h, main.c, wifi_config.h]
2026-02-05 feat: 添加WiFi联网与Web配置功能
    - 新增SNTP时间同步模块 (sntp_time/)
    - 新增SPIFFS文件系统初始化模块 (spiffs_init/)
    - 新增嵌入式Web配置页面 (web_html.h)
    - 扩展WiFi配置模块，添加API路由 (config/time/upload/wifi)
    - 修改main.c集成SPIFFS初始化
    - WiFi连接成功后自动启动SNTP时间同步
2026-02-05 feat: 完成背景上传、WiFi配置保存及自定义快捷键功能完善
2026-02-05 fix: 修复 dependencies.lock 中的硬编码绝对路径并更新配置
2026-02-05 chore: 在 .gitignore 中忽略所有 .old 文件
2026-02-05 chore: 停止追踪 sdkconfig.old 备份文件
